Gbade-O/Senior-Design-GUI/Hardware/photos/IMG_20170424_153510.jpg

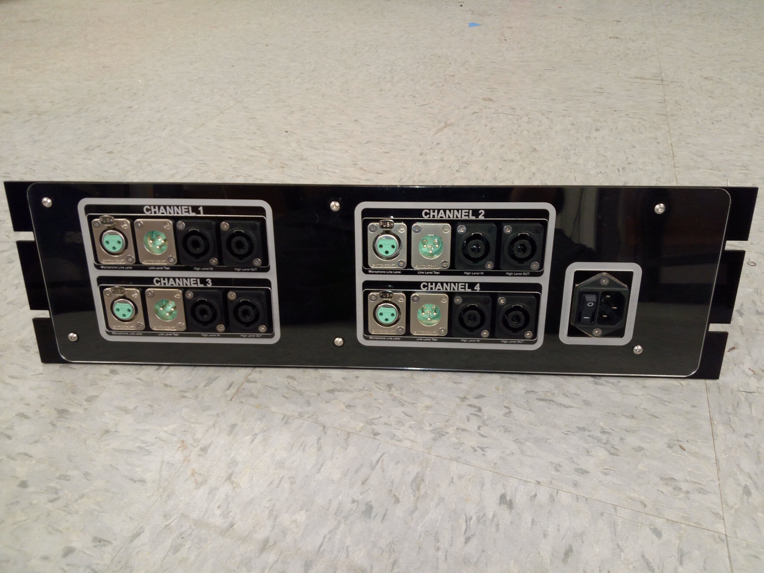
Hardware/photos/IMG_20170424_153510.jpg
