Gbade-O/Senior-Design-GUI/Hardware/Panel Overlays/3U_REAR_PANEL_OVERLAY.pdf

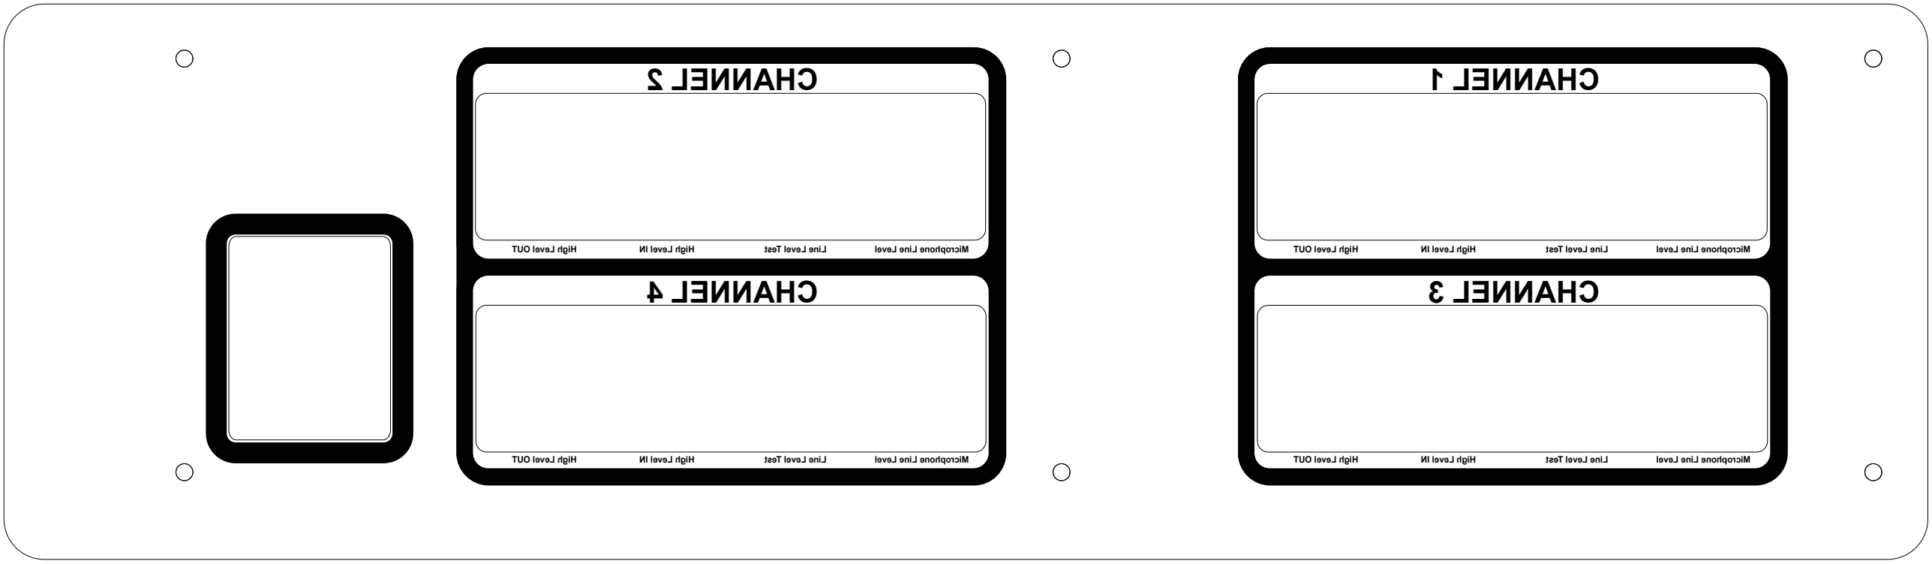
[picture p3: figure]
CHANNEL 2; CHANNEL 4; CHANNEL 1; CHANNEL 3

Microphone Line Level Line Level Test High Level IN High Level OUT

Microphone Line Level Line Level Test High Level IN High Level OUT

Microphone Line Level Line Level Test High Level IN High Level OUT

Microphone Line Level Line Level Test High Level IN High Level OUT
