Gbade-O/Senior-Design-GUI/Hardware/DPDT_Dimensions.PNG

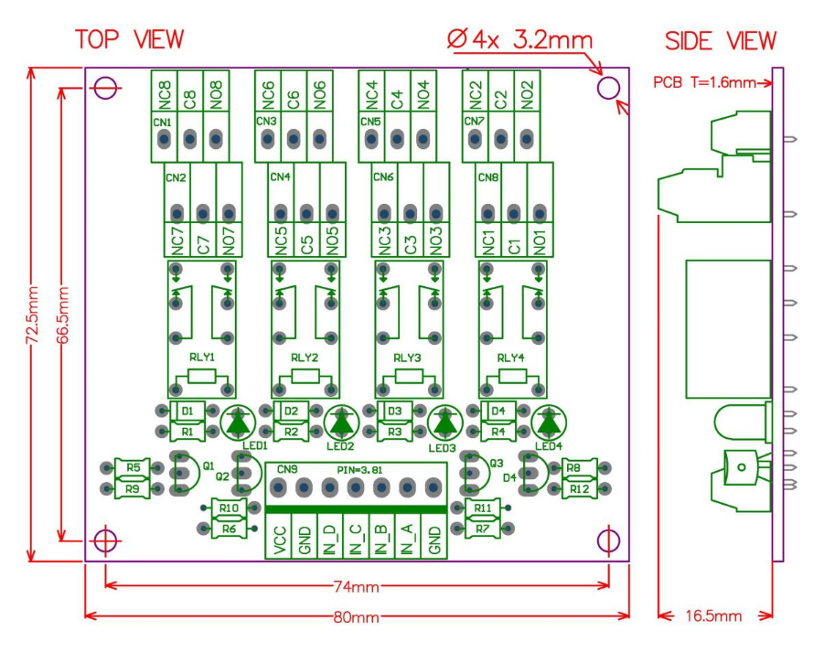
Hardware/DPDT_Dimensions.PNG
