Gbade-O/Senior-Design-GUI/Hardware/HardwareSystemRevB.PNG

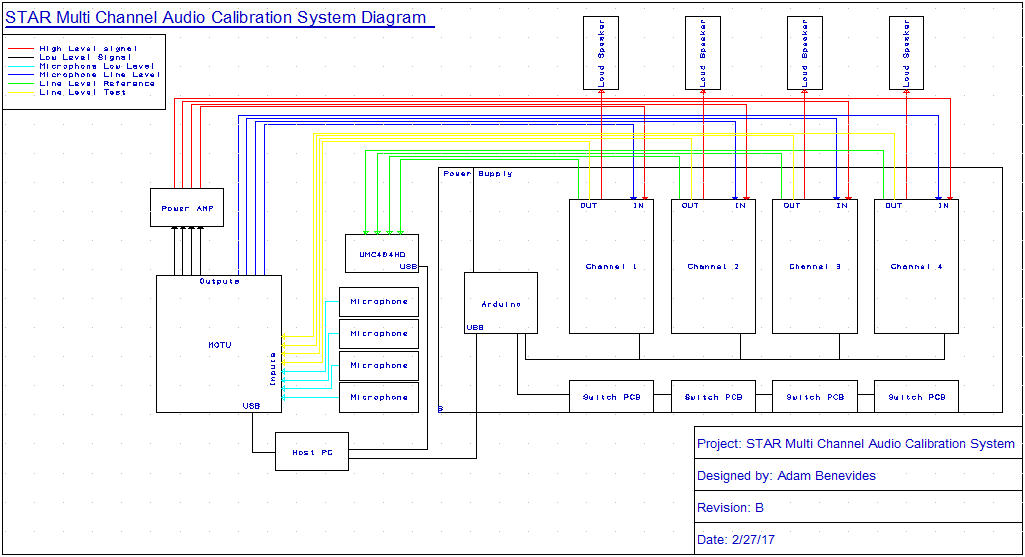
Hardware/HardwareSystemRevB.PNG
