Gbade-O/Senior-Design-GUI/Hardware/Mega_Dimensions.PNG

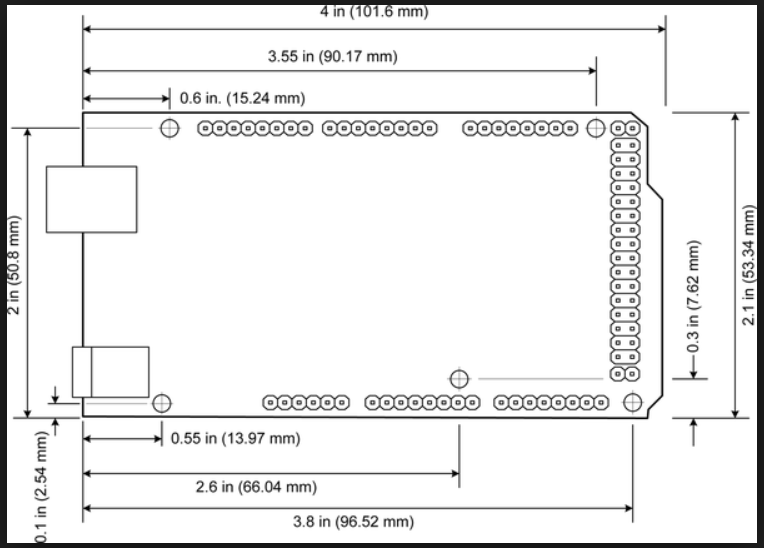
Hardware/Mega_Dimensions.PNG
