Gbade-O/Senior-Design-GUI/Hardware/Panels/Capture.PNG

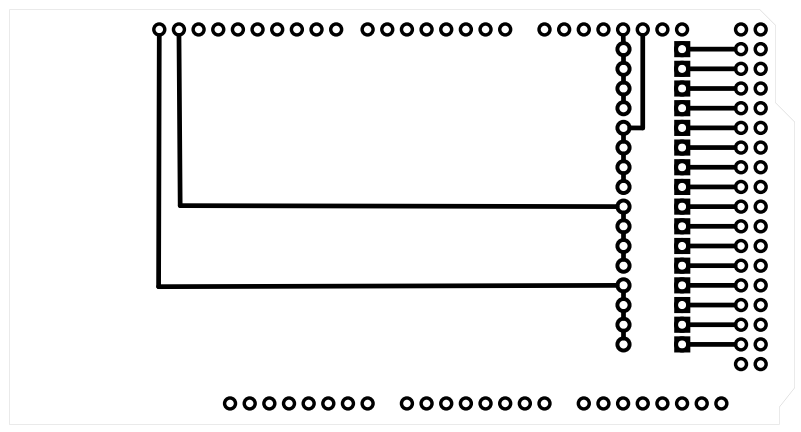
Hardware/Panels/Capture.PNG
