Gbade-O/Senior-Design-GUI/Hardware/Panels/FRONT_PANEL.PNG

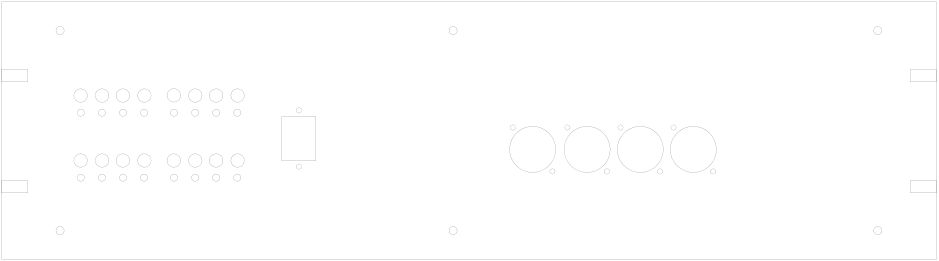
Hardware/Panels/FRONT_PANEL.PNG
