Gbade-O/Senior-Design-GUI/Hardware/Panels/FRONT_PANEL_BRACE.PNG

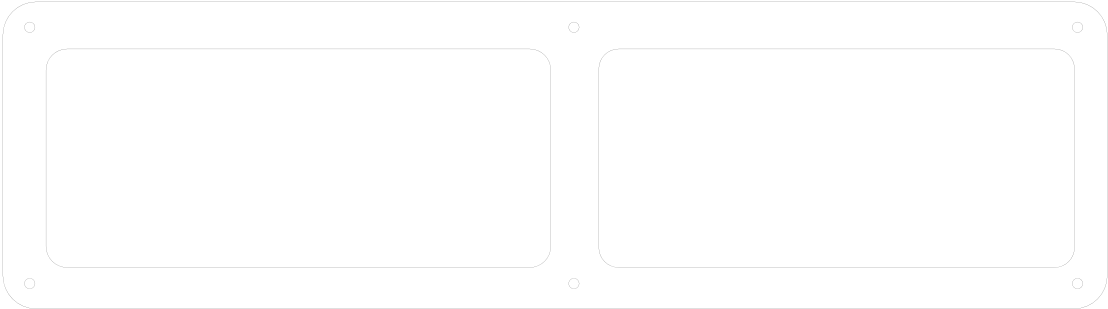
Hardware/Panels/FRONT_PANEL_BRACE.PNG
