Gbade-O/Senior-Design-GUI/Hardware/Panels/FRONT_PANEL_OVERLAY.PNG

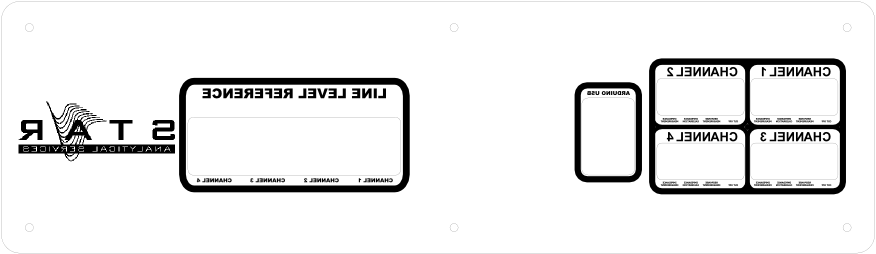
Hardware/Panels/FRONT_PANEL_OVERLAY.PNG
