Gbade-O/Senior-Design-GUI/Hardware/Panels/INTERNAL_PANEL.PNG

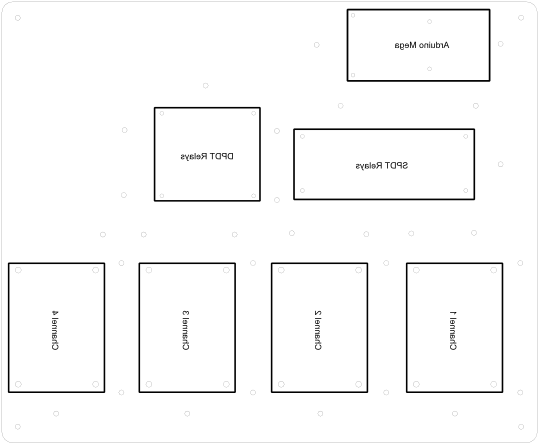
Hardware/Panels/INTERNAL_PANEL.PNG
