Gbade-O/Senior-Design-GUI/Hardware/Panels/REAR_PANEL.PNG

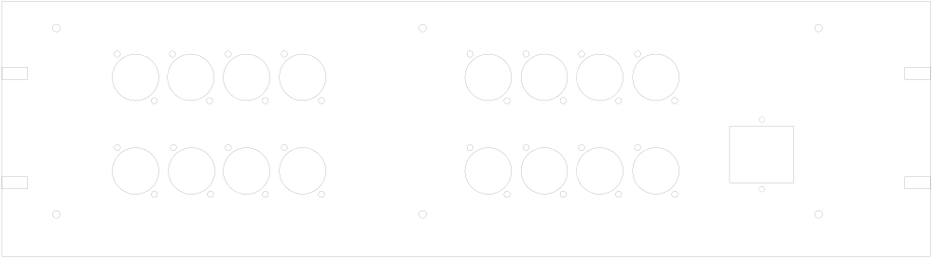
Hardware/Panels/REAR_PANEL.PNG
