Gbade-O/Senior-Design-GUI/Hardware/Panels/REAR_PANEL_BRACE.PNG

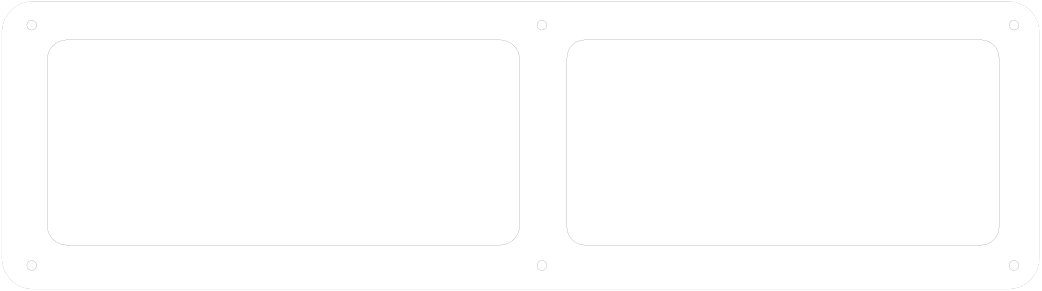
Hardware/Panels/REAR_PANEL_BRACE.PNG
