Gbade-O/Senior-Design-GUI/Hardware/Panels/REAR_PANEL_OVERLAY.PNG

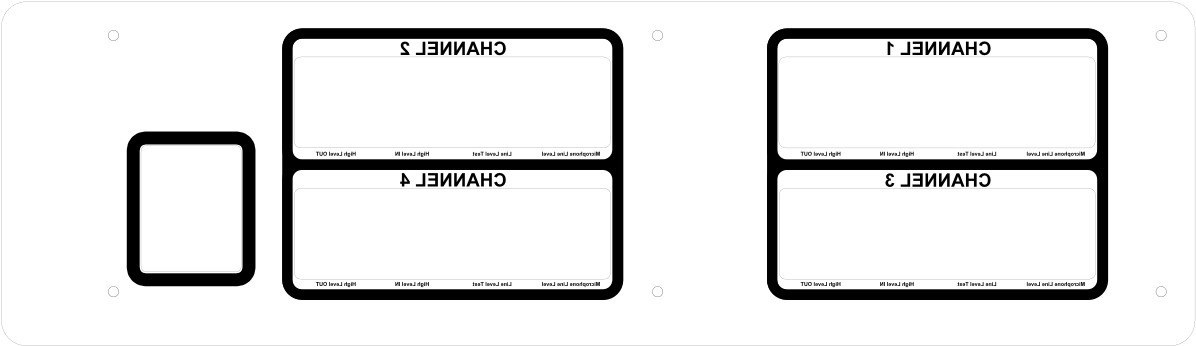
Hardware/Panels/REAR_PANEL_OVERLAY.PNG
