Gbade-O/Senior-Design-GUI/Hardware/photos/IMG_20170407_110844.jpg

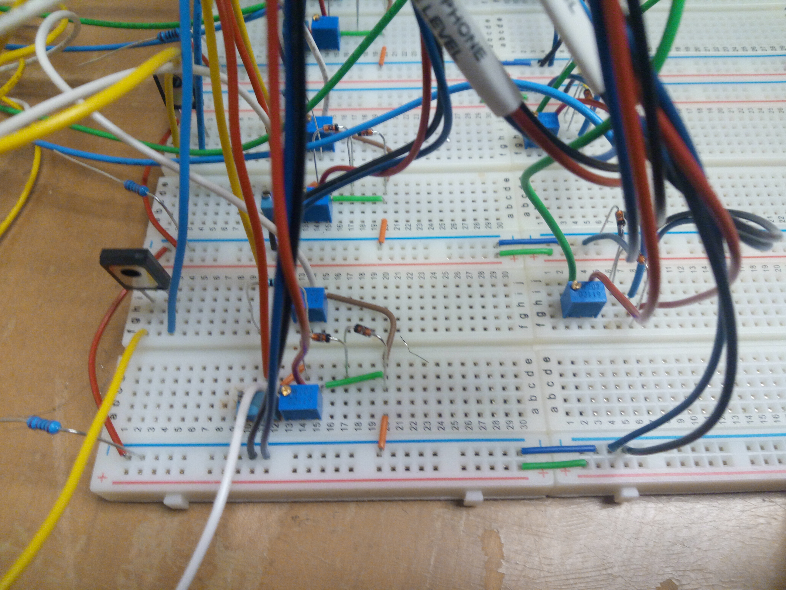
Hardware/photos/IMG_20170407_110844.jpg
