Gbade-O/Senior-Design-GUI/Hardware/photos/IMG_20170407_110850.jpg

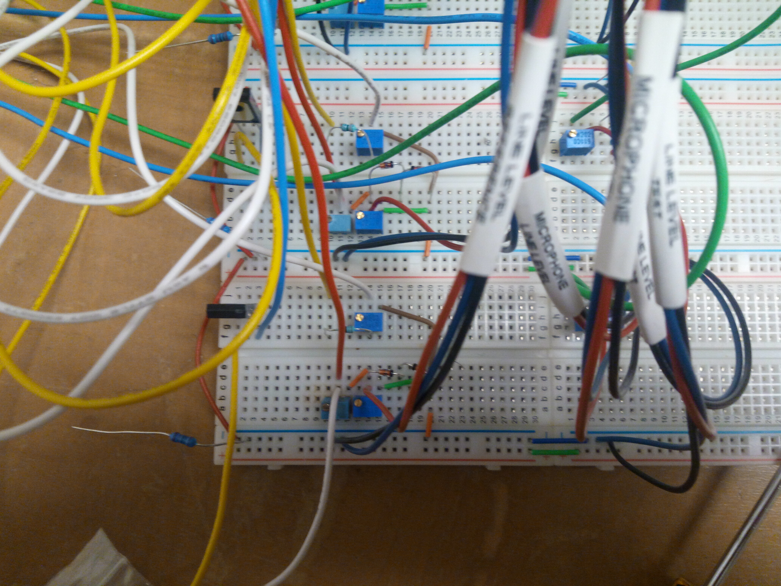
Hardware/photos/IMG_20170407_110850.jpg
