Gbade-O/Senior-Design-GUI/Hardware/photos/IMG_20170414_150326.jpg

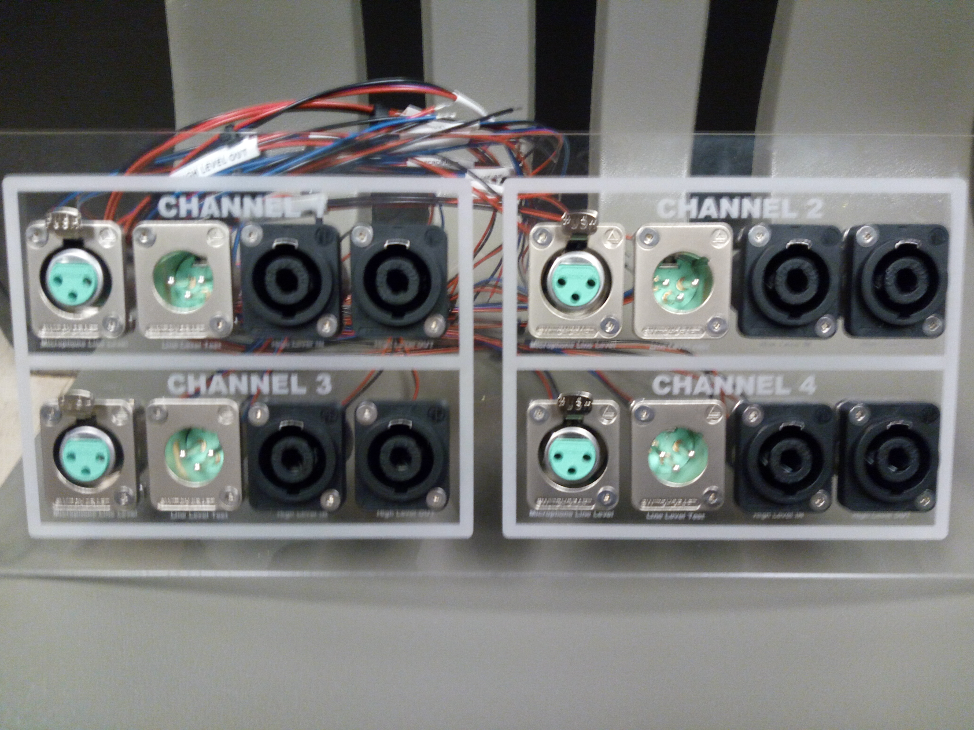
Hardware/photos/IMG_20170414_150326.jpg
