Gbade-O/Senior-Design-GUI/Hardware/photos/IMG_20170421_161729.jpg

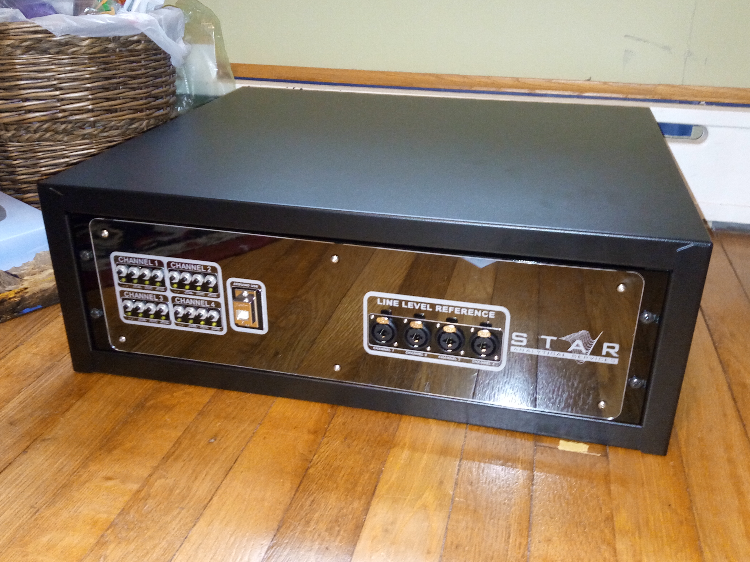
Hardware/photos/IMG_20170421_161729.jpg
