Gbade-O/Senior-Design-GUI/Hardware/photos/IMG_20170422_165607.jpg

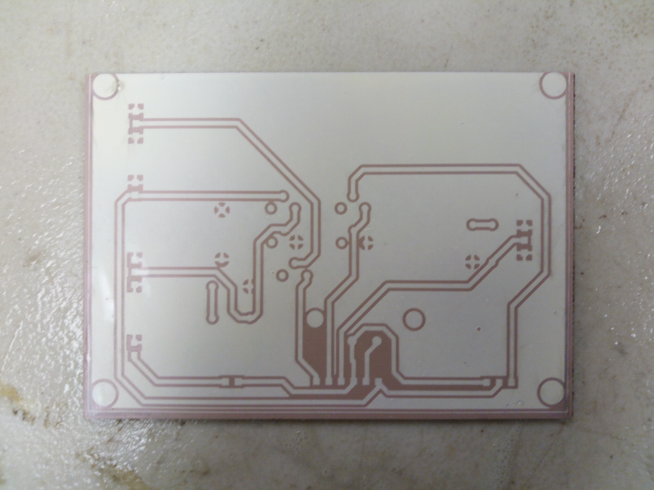
Hardware/photos/IMG_20170422_165607.jpg
