Gbade-O/Senior-Design-GUI/Hardware/photos/IMG_20170422_202816.jpg

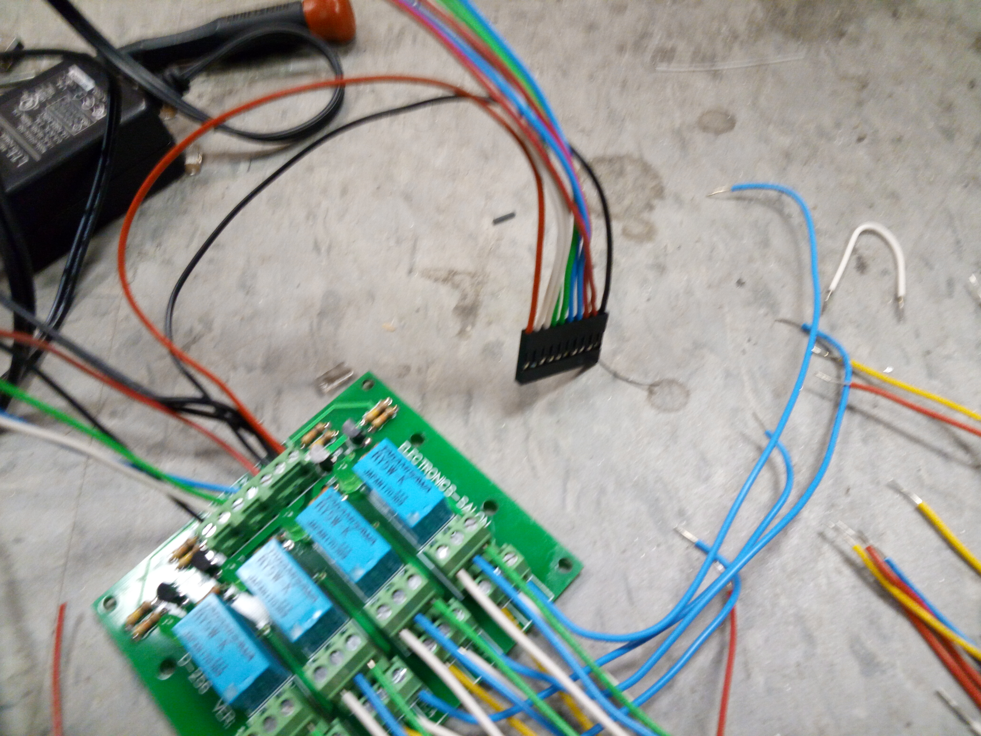
Hardware/photos/IMG_20170422_202816.jpg
