Gbade-O/Senior-Design-GUI/Hardware/photos/IMG_20170424_152419.jpg

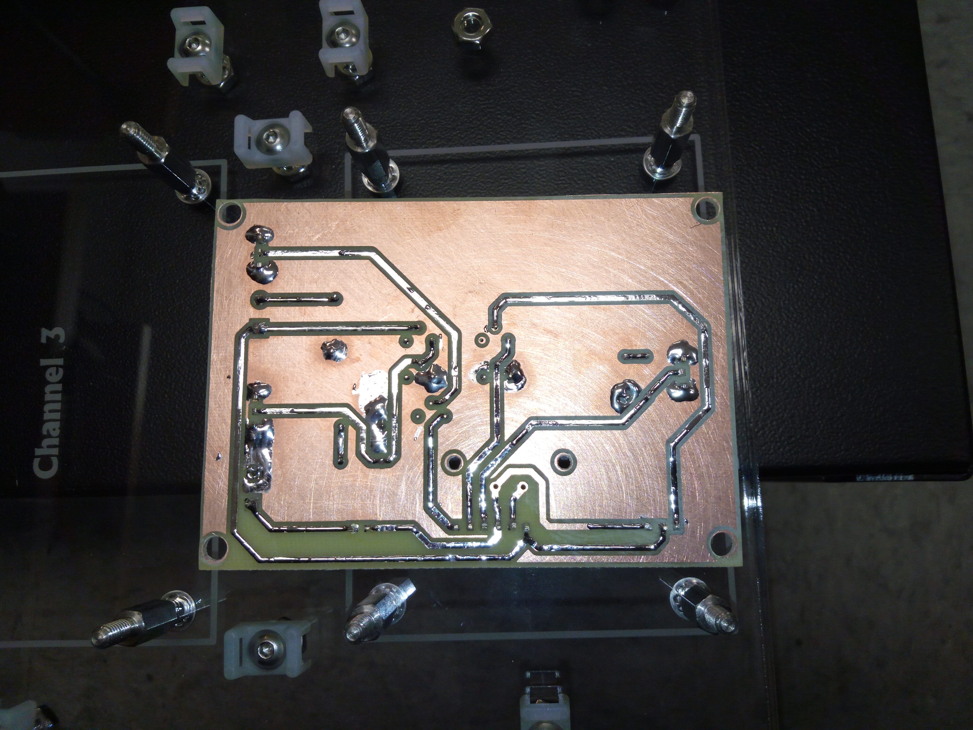
Hardware/photos/IMG_20170424_152419.jpg
