Gbade-O/Senior-Design-GUI/Hardware/photos/IMG_20170424_153402.jpg

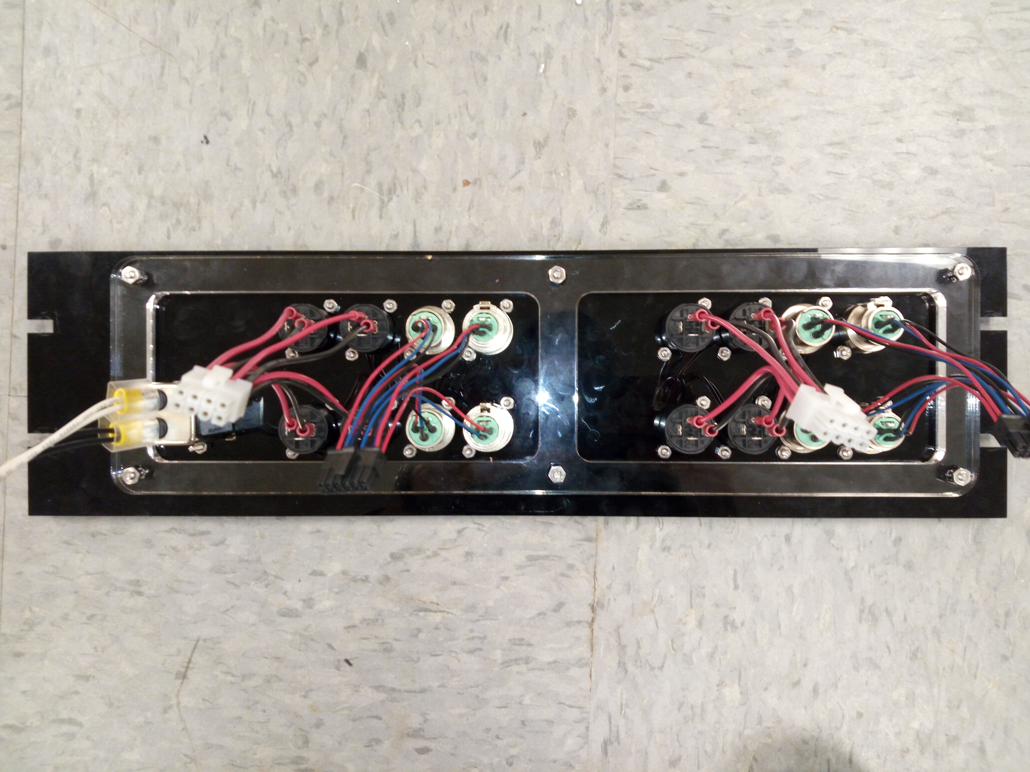
Hardware/photos/IMG_20170424_153402.jpg
