Gbade-O/Senior-Design-GUI/Hardware/photos/IMG_20170424_153427.jpg

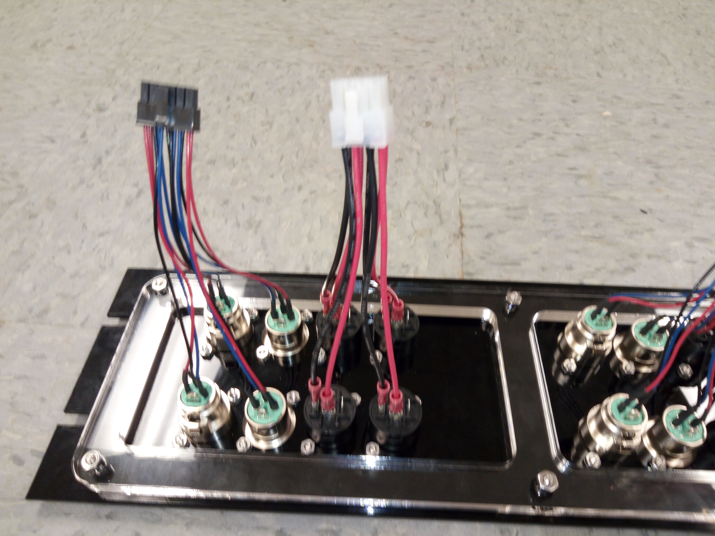
Hardware/photos/IMG_20170424_153427.jpg
