Gbade-O/Senior-Design-GUI/Hardware/photos/IMG_20170424_153449.jpg

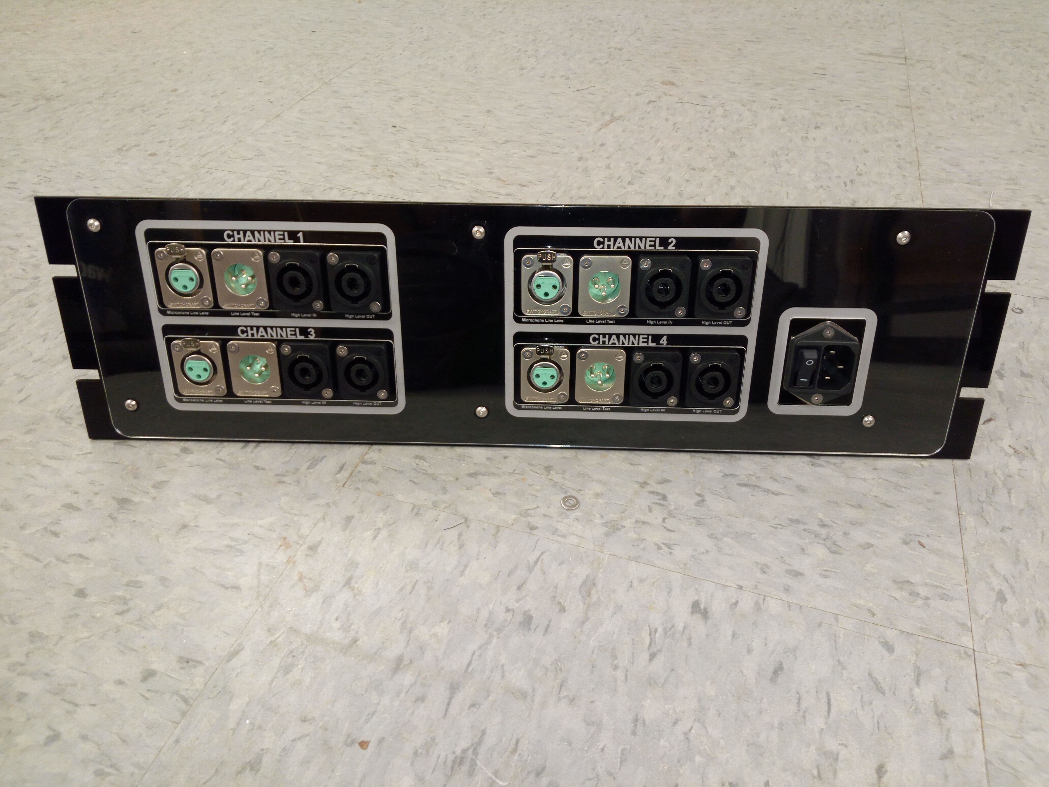
Hardware/photos/IMG_20170424_153449.jpg
