Gbade-O/Senior-Design-GUI/Hardware/photos/IMG_20170426_191719.jpg

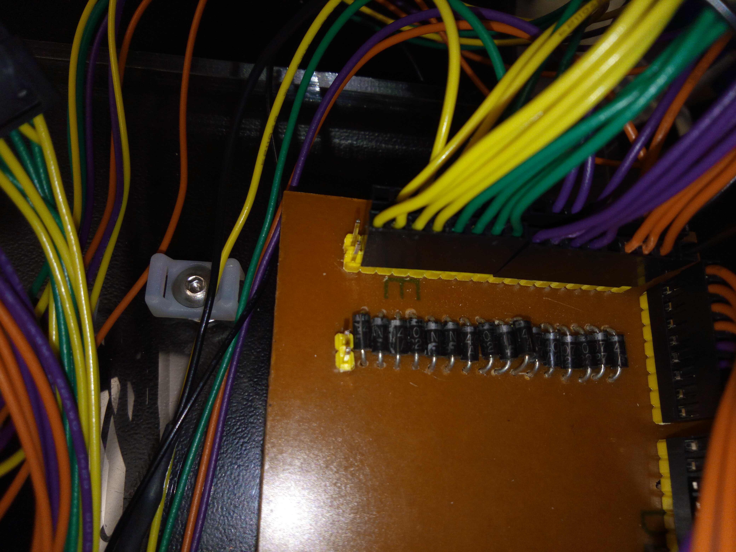
Hardware/photos/IMG_20170426_191719.jpg
