Gbade-O/Senior-Design-GUI/Hardware/photos/IMG_20170426_210206.jpg

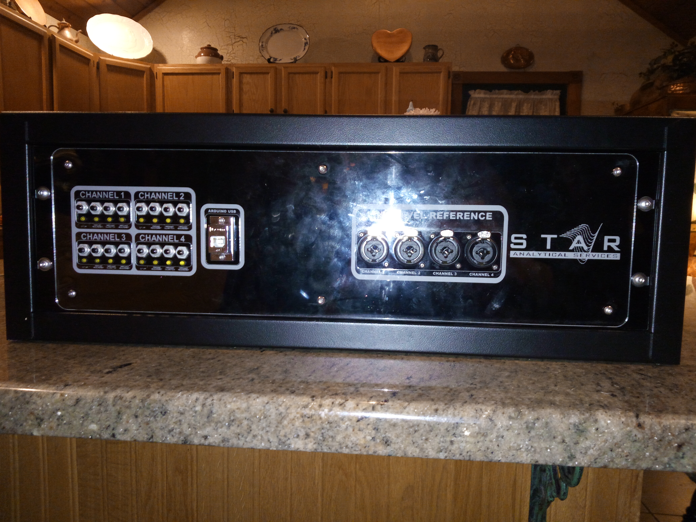
Hardware/photos/IMG_20170426_210206.jpg
