Gbade-O/Senior-Design-GUI/Hardware/photos/IMG_20170426_210301.jpg

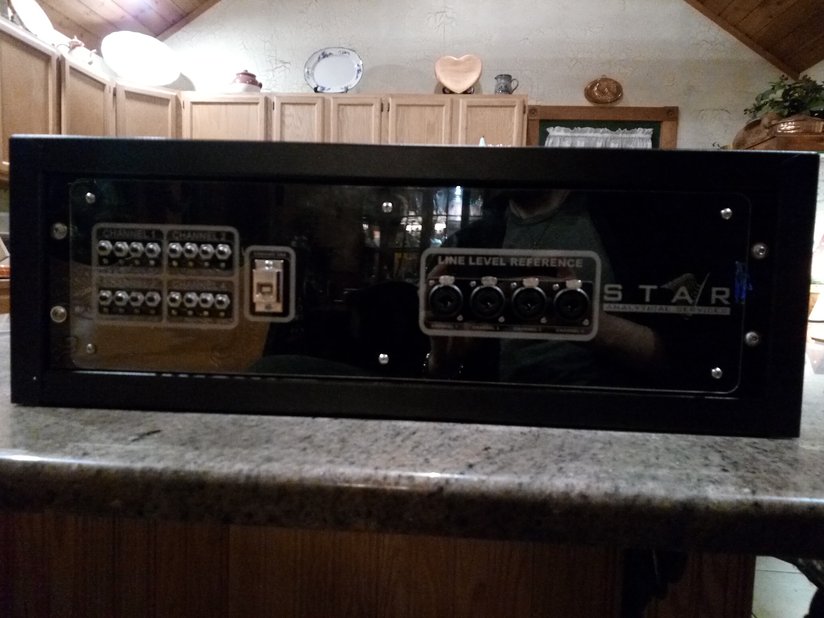
Hardware/photos/IMG_20170426_210301.jpg
