Gbade-O/Senior-Design-GUI/Hardware/photos/IMG_20170426_212249.jpg

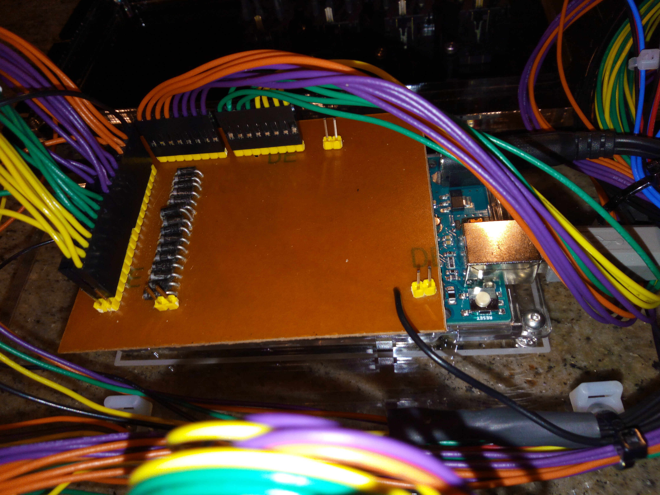
Hardware/photos/IMG_20170426_212249.jpg
