Gbade-O/Senior-Design-GUI/Hardware/MeasurementBox_Rev_C_BOM.xlsx

 | STAR Multi Channel Audio Calibration System
 | Four Track Measuring Box Rev:C
 | 2017-04-30
ITEM # | DESCRIPTION | MFG. | MFG. P/N | VENDOR | VENDOR P/N | QTY REQ. | UNIT COST | SYSTEM COST | REFERENCE DESIGNATOR
1 | TRIMMER, 10K OHM 1/4W | BOURNES | PV37W103C01B00 | DIGIKEY | 490-2970-ND | 3 | $2.29 | $6.87 | N/A
2 | TRIMMER, 2K OHM 1/4W | BOURNES | 3266W-1-202LF | DIGIKEY | 3266W-202LF-ND | 4 | $4.16 | $16.64 | N/A
3 | RESISTOR, 8.2K OHM 1/4W 1% AXIAL | STACKPOLE ELECTRONICS | RNMF14FTC8K20 | DIGI-KEY | S8.2KCACT-ND | 10 | $0.10 | $1.00 | R1,R3
4 | RESISTOR, 1K OHM 1/4W 1% AXIAL | YAGEO | MFR-25FBF52-1K | DIGI-KEY | 1.00KXBK-ND | 10 | $0.10 | $1.00 | R6
5 | RESISTOR, 910 OHM 1/4W 1% AXIAL | STACKPOLE ELECTRONICS | RNMF14FTC910R | DIGI-KEY | S910CACT-ND | 10 | $0.10 | $1.00 | R2,R4
6 | RESISTOR, 220 OHM 1/4W 1% AXIAL | STACKPOLE ELECTRONICS | RNMF14FTC220R | DIGI-KEY | S220CACT-ND | 20 | $0.07 | $1.44 | N/A
7 | RESISTOR, 715 OHM 1/4W 1% AXIAL | YAGEO | MFR-25FBF52-715R | DIGI-KEY | 715XBK-ND | 10 | $0.10 | $1.00 | R5
8 | RESISTOR, 27 OHM 10W 1% TO126 | OHMITE | TNP10SC27R0FE | DIGIKEY | TNP10SC27R0FE-ND | 5 | $3.08 | $15.40 | R9
9 | HEATSINK, TO-126 1 CLIP | OHMITE | C126-025-1VE | MOUSER | 588-C126-025-1VE | 5 | $3.18 | $15.90 | N/A
10 | CONNECTOR, XLR FEMALE, 1/4", HYBRID | NEUTRIK | NCJ6FI-S | MOUSER | 568-NCJ6FI-S | 5 | $3.35 | $16.75 | LINE LEVEL REF
11 | CONNECTOR, XLR FEMALE 3P | SWITCHCRAFT | DE3F | MOUSER | 502-DE3F | 5 | $2.56 | $12.80 | IN1,IN2,IN3,IN4
12 | CONNECTOR, SpeakON FEMALE 4P | NEUTRIK | NL4MP | MOUSER | 568-NL4MP | 9 | $2.67 | $24.03 | PA1,PA2,PA3,PA4 LS1,LS2,LS3,LS4
13 | CONNECTOR, USB Adapter B-A, Shielded | L-COM | ECF504-BAS | NEWARK | 22J8057 | 1 | $9.35 | $9.35 | ARDUINO USB
14 | CONNECTOR, XLR MALE 3P | SWITCHCRAFT | DE3M | MOUSER | 502-DE3M | 5 | $3.75 | $18.75 | OUT1,OUT2,OUT3,OUT4,OUT5,OUT6,OUT7,OUT8
15 | DIODE, 1N4001 | MICRO COMMERCIAL CO | 1N4001-TP | DIGIKEY | 1N4001-TPMSTR-ND | 16 | $0.10 | $1.66 | D5,D6,D7,D8,D9,D10,D11,D12,D13,D14,D15,D16,D17,D18,D19,D20
16 | DIODE, ZENER 4.1V AXIAL | NXP | BZX79-C3V9,113 | MOUSER | 771-BZX79-C3V9113 | 20 | $0.13 | $2.60 | D1,D2,D3,D4
17 | RELAY BOARD, SPDT | ELEGOO | 8-CHNL RELAY | AMAZON | N/A | 1 | $9.99 | $9.99 | N/A
18 | RELAY BOARD, DPDT | ELECTRONICS-SALON | MD-D256/12V-1 | AMAZON | N/A | 1 | $21.99 | $21.99 | N/A
19 | PUSH BUTTON | GRAYHILL | 30-3 | MOUSER | 706-30-3 | 17 | $2.70 | $45.90 | MODE1,MODE2,MODE3,MODE4
20 | ATMEGA328P ARDUINO MEGA | ARDUINO | A000067 | DIGIKEY | 1050-1018-ND | 1 | $26.13 | $26.13 | N/A
21 | A/D CONVERTER | BEHRINGER | UMC404HD | BHPHOTOVIDEO | BEUMC404HD | 1 | $99.99 | $99.99 | N/A
22 | CABLE, XLR M to XLR F | PEARSTONE | SM-15 | BHPHOTOVIDEO | PESM15 | 8 | $7.49 | $59.92 | N/A
23 | CABLE, 1/4" M to 1/4" M PHONO | HOSA | CPP-801 | SWEETWATER | CPP-801 | 5 | $21.99 | $109.95 | N/A
24 | CABLE, SpeakON | GLS AUDIO | 37-430 | AMAZON | 37-430 | 6 | $39.99 | $239.94 | N/A
25 | HOOKUP WIRE, VARIOUS COLORS 22AWG | AWC | UL-1007 | AWC | UL-1007 | 1 | by length | by length | N/A
26 | HOOKUP WIRE, VARIOUS COLORS 16AWG | AWC | UL-1007 | AWC | UL-1007 | 1 | by length | by length | N/A
27 | HOOKUP WIRE, VARIOUS COLORS 24AWG | AWC | UL-1007 | AWC | UL-1007 | 1 | by length | by length | N/A
 |  |  |  |  |  |  | TOTAL | $760.00
NOTE: All parts listed on this BOM depict ONLY the electronics required to make a FTMB. All hardware is arbitrarily selected by the assembler.
All designed components (PCBs, panels, etc.) were manufactured in-house and by hand.
The original FTMB was created with the help of an Epilog HELIX Laser System, graciously lent out by Electromechanica Inc.
