Gbade-O/Senior-Design-GUI/Hardware/PCB/MeasurementBox_Rev_A_BOM.xlsx

 | STAR Multi Channel Audio Calibration System
 | Measuring Box Single Channel PCB Rev:A
 | 2016-12-07
ITEM # | DESCRIPTION | MFG. | MFG. P/N | VENDOR | VENDOR P/N | QTY REQ. | UNIT COST | SYSTEM COST | REFERENCE DESIGNATOR
1 | RESISTOR, 8.2K OHM 1/4W 1% AXIAL | STACKPOLE ELECTRONICS | RNMF14FTC8K20 | DIGI-KEY | S8.2KCACT-ND | 8 | $0.10 | $0.80 | R1,R3
2 | RESISTOR, 1K OHM 1/4W 1% AXIAL | YAGEO | MFR-25FBF52-1K | DIGI-KEY | 1.00KXBK-ND | 4 | $0.10 | $0.40 | R6
3 | RESISTOR, 910 OHM 1/4W 1% AXIAL | STACKPOLE ELECTRONICS | RNMF14FTC910R | DIGI-KEY | S910CACT-ND | 8 | $0.10 | $0.80 | R2,R4
4 | RESISTOR, 715 OHM 1/4W 1% AXIAL | YAGEO | MFR-25FBF52-715R | DIGI-KEY | 715XBK-ND | 4 | $0.10 | $0.40 | R5
5 | RESISTOR, 27 OHM 10W 1% TO126 | OHMITE | TNP10SC27R0FE | DIGIKEY | TNP10SC27R0FE-ND | 4 | $3.08 | $12.32 | R9
6 | CONNECTOR, XLR FEMALE 3P R/A | NEUTRIK | 3FD-V-I-0 | MOUSER | 568-3FD-V-I-0 | 16 | $2.56 | $40.96 | J3,J4,J5,J6
7 | CONNECTOR, XLR MALE 3P R/A | NEUTRIK | NC3MD-H-BAG | MOUSER | 568-NC3MDHBAG | 4 | $3.75 | $15.00 | J1
8 | DIODE, ZENER 4.1V AXIAL | NXP | BZX79-C3V9,113 | MOUSER | 771-BZX79-C3V9113 | 16 | $0.13 | $2.08 | D1,D2,D3,D4
9 | RELAY SPDT | OMRON | G5V-1-DC5 | DIGIKEY | Z773-ND | 4 | $1.99 | $7.96 | K2
10 | RELAY DPDT | OMRON | G5V-2-DC5 | DIGIKEY | Z767-ND | 4 | $2.88 | $11.52 | K1
11 | ATMEGA328P ARDUINO UNO | ARDUINO | A000099 | DIGIKEY | 1050-1124-ND | 1 | $26.13 | $26.13
12 | RACK PROJECT BOX 1U SILVER FACE | PENN ELCOM | R2100 | MCMELECTRONICS | 555-20825 | 1 | $59.99 | $59.99
13 | MEASURING BOX PCB |  |  |  |  | 4 | N/A | N/A
 |  |  |  |  |  |  | TOTAL | $178.36
