Gbade-O/Senior-Design-GUI/Hardware/Measurement_Box_Single_Channel_Rev-C_BOM.PNG

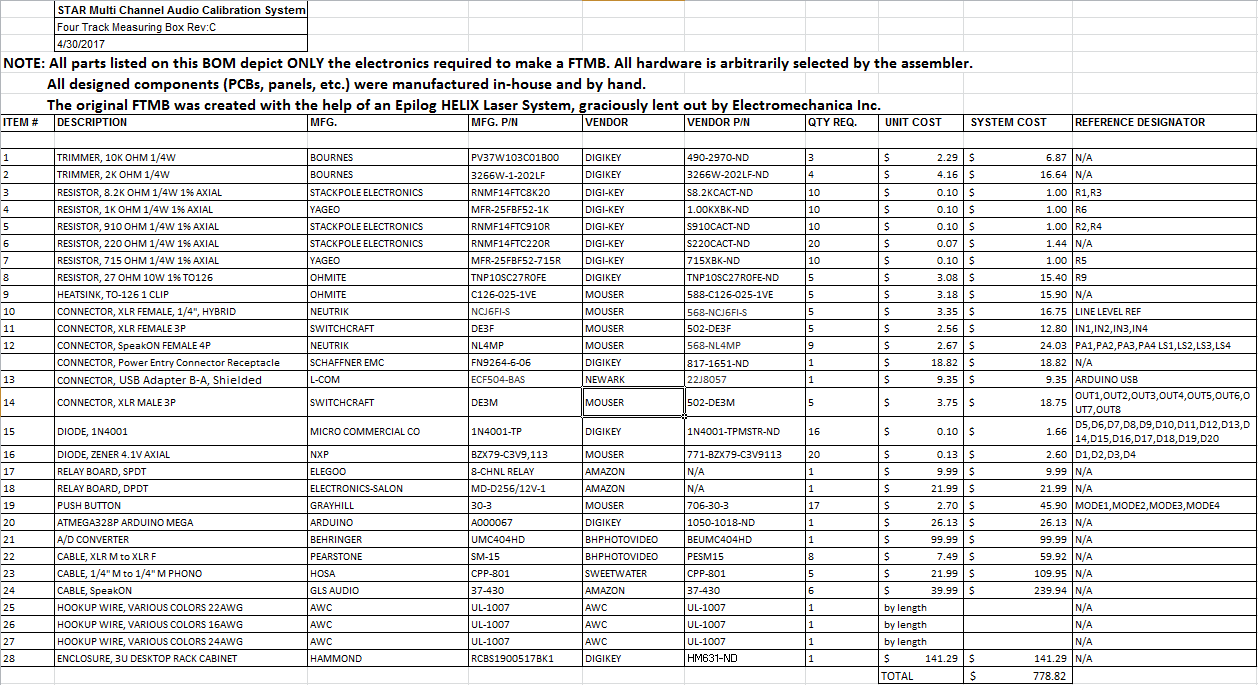
Hardware/Measurement_Box_Single_Channel_Rev-C_BOM.PNG
