Gbade-O/Senior-Design-GUI/Hardware/PCB/MeasurementBox_Channel1_Rev_C (PCB - Design Integrity Status Report).txt

Design Integrity Status Report
------------------------------

Report File    : C:\Users\Public\Documents\Easy-PC\Senior Design Project\MeasurementBox_Channel1_Rev_C (PCB - Design Integrity Status Report).txt
Report Written : Sunday, April 23, 2017
Design Path    : C:\Users\Public\Documents\Easy-PC\Senior Design Project\MeasurementBox_Channel1_Rev_C.pcb
Design Title   : 
Created        : 4/19/2017 4:24:52 PM
Last Saved     : 4/23/2017 11:36:15 AM
Editing Time   : 4298 min
Units          : thou (precision 0)

Checking integrity of Schematic "C:\Users\Public\Documents\Easy-PC\Senior Design Project\MeasurementBox_Channel1_Rev_C.sch" with PCB "C:\Users\Public\Documents\Easy-PC\Senior Design Project\MeasurementBox_Channel1_Rev_C.pcb"
================================================================================================================================================================================================================================

End Of Report.
