Gbade-O/Senior-Design-GUI/Hardware/PCB/MeasurementBox_Channel1_Rev_C - PCB.png

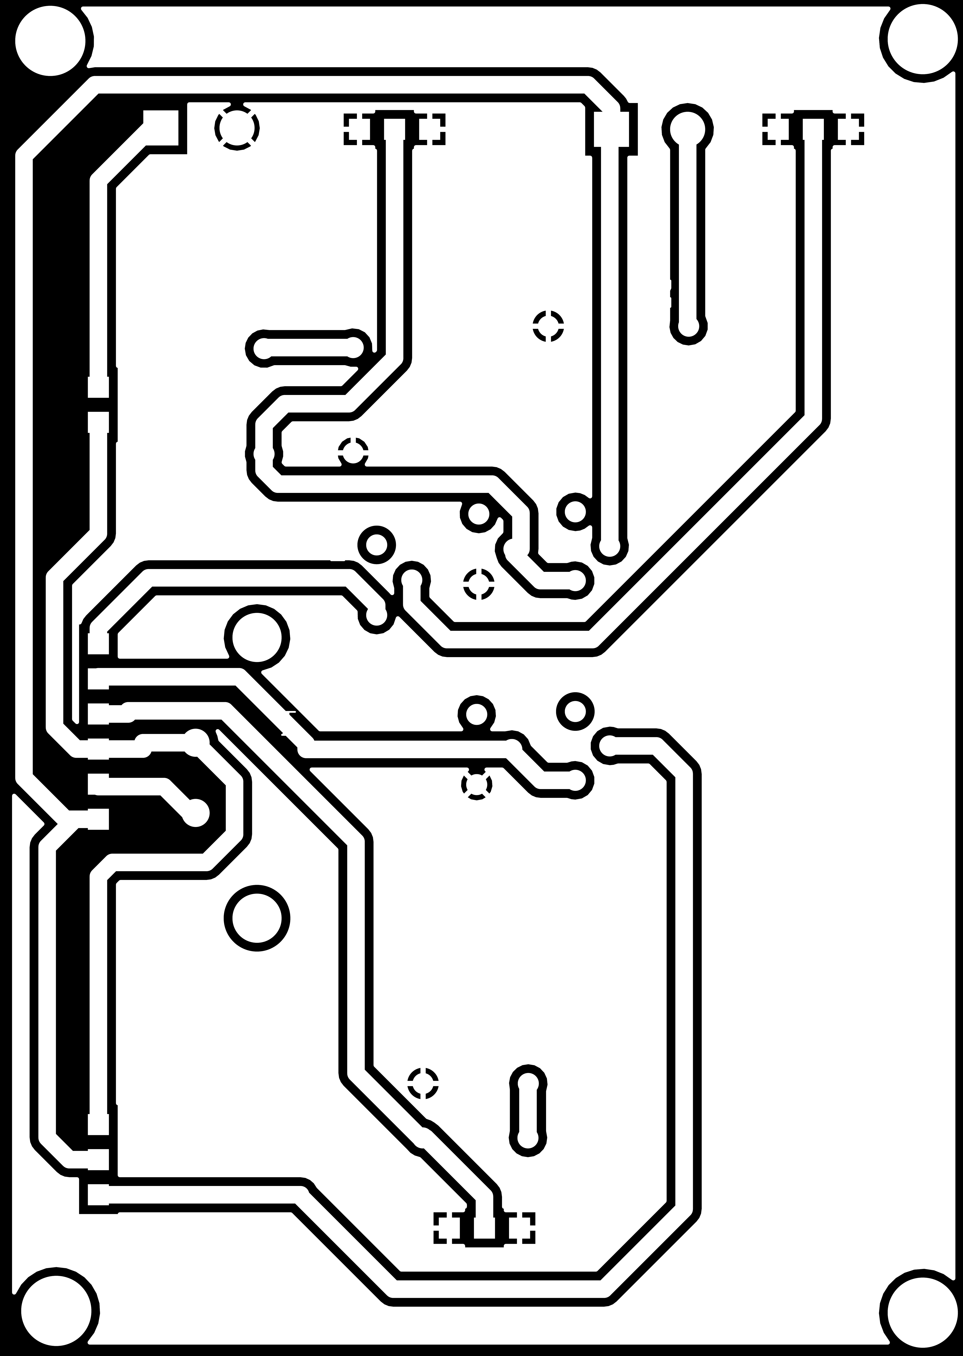
Hardware/PCB/MeasurementBox_Channel1_Rev_C - PCB.png
