Gbade-O/Senior-Design-GUI/Hardware/Panel Overlays/3U_FRONT_PANEL_OVERLAY.pdf

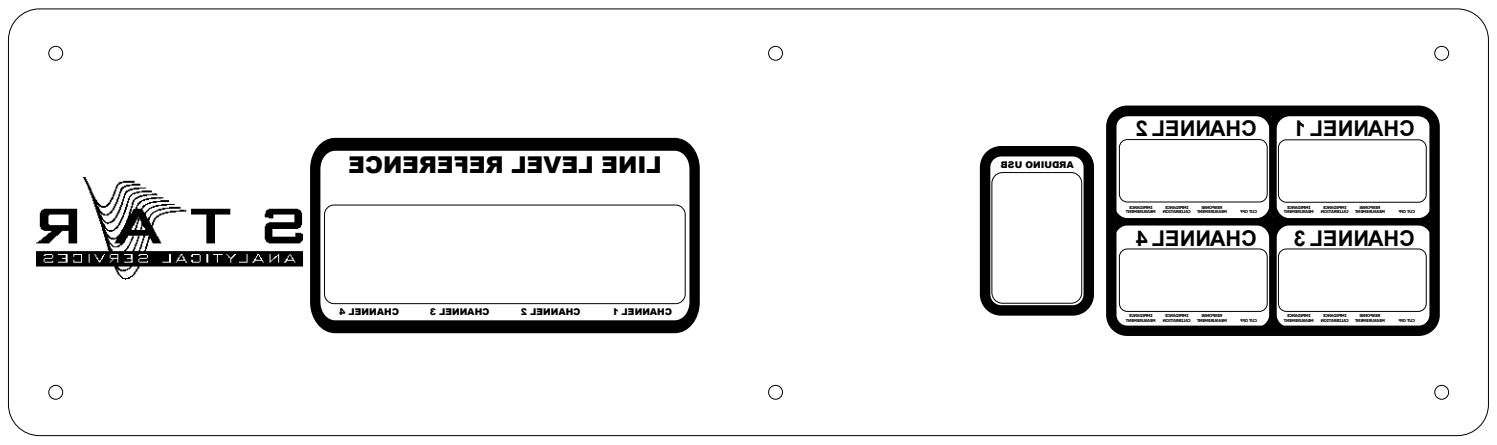
[picture p64: page 1]
CUT OFF; RESPONSE MEASUREMENT; IMPEDANCE CALIBRATION; IMPEDANCE MEASUREMENT; CHANNEL 1; ARDUINO USB; CHANNEL 2; CHANNEL 3; CHANNEL 4

LINE LEVEL REFERENCE

CHANNEL 4 CHANNEL 1 CHANNEL 2 CHANNEL 3
