Gbade-O/Senior-Design-GUI/Hardware/PCB/MeasurementBox_Channel1_Rev_C - PCB.pdf

J1

J4

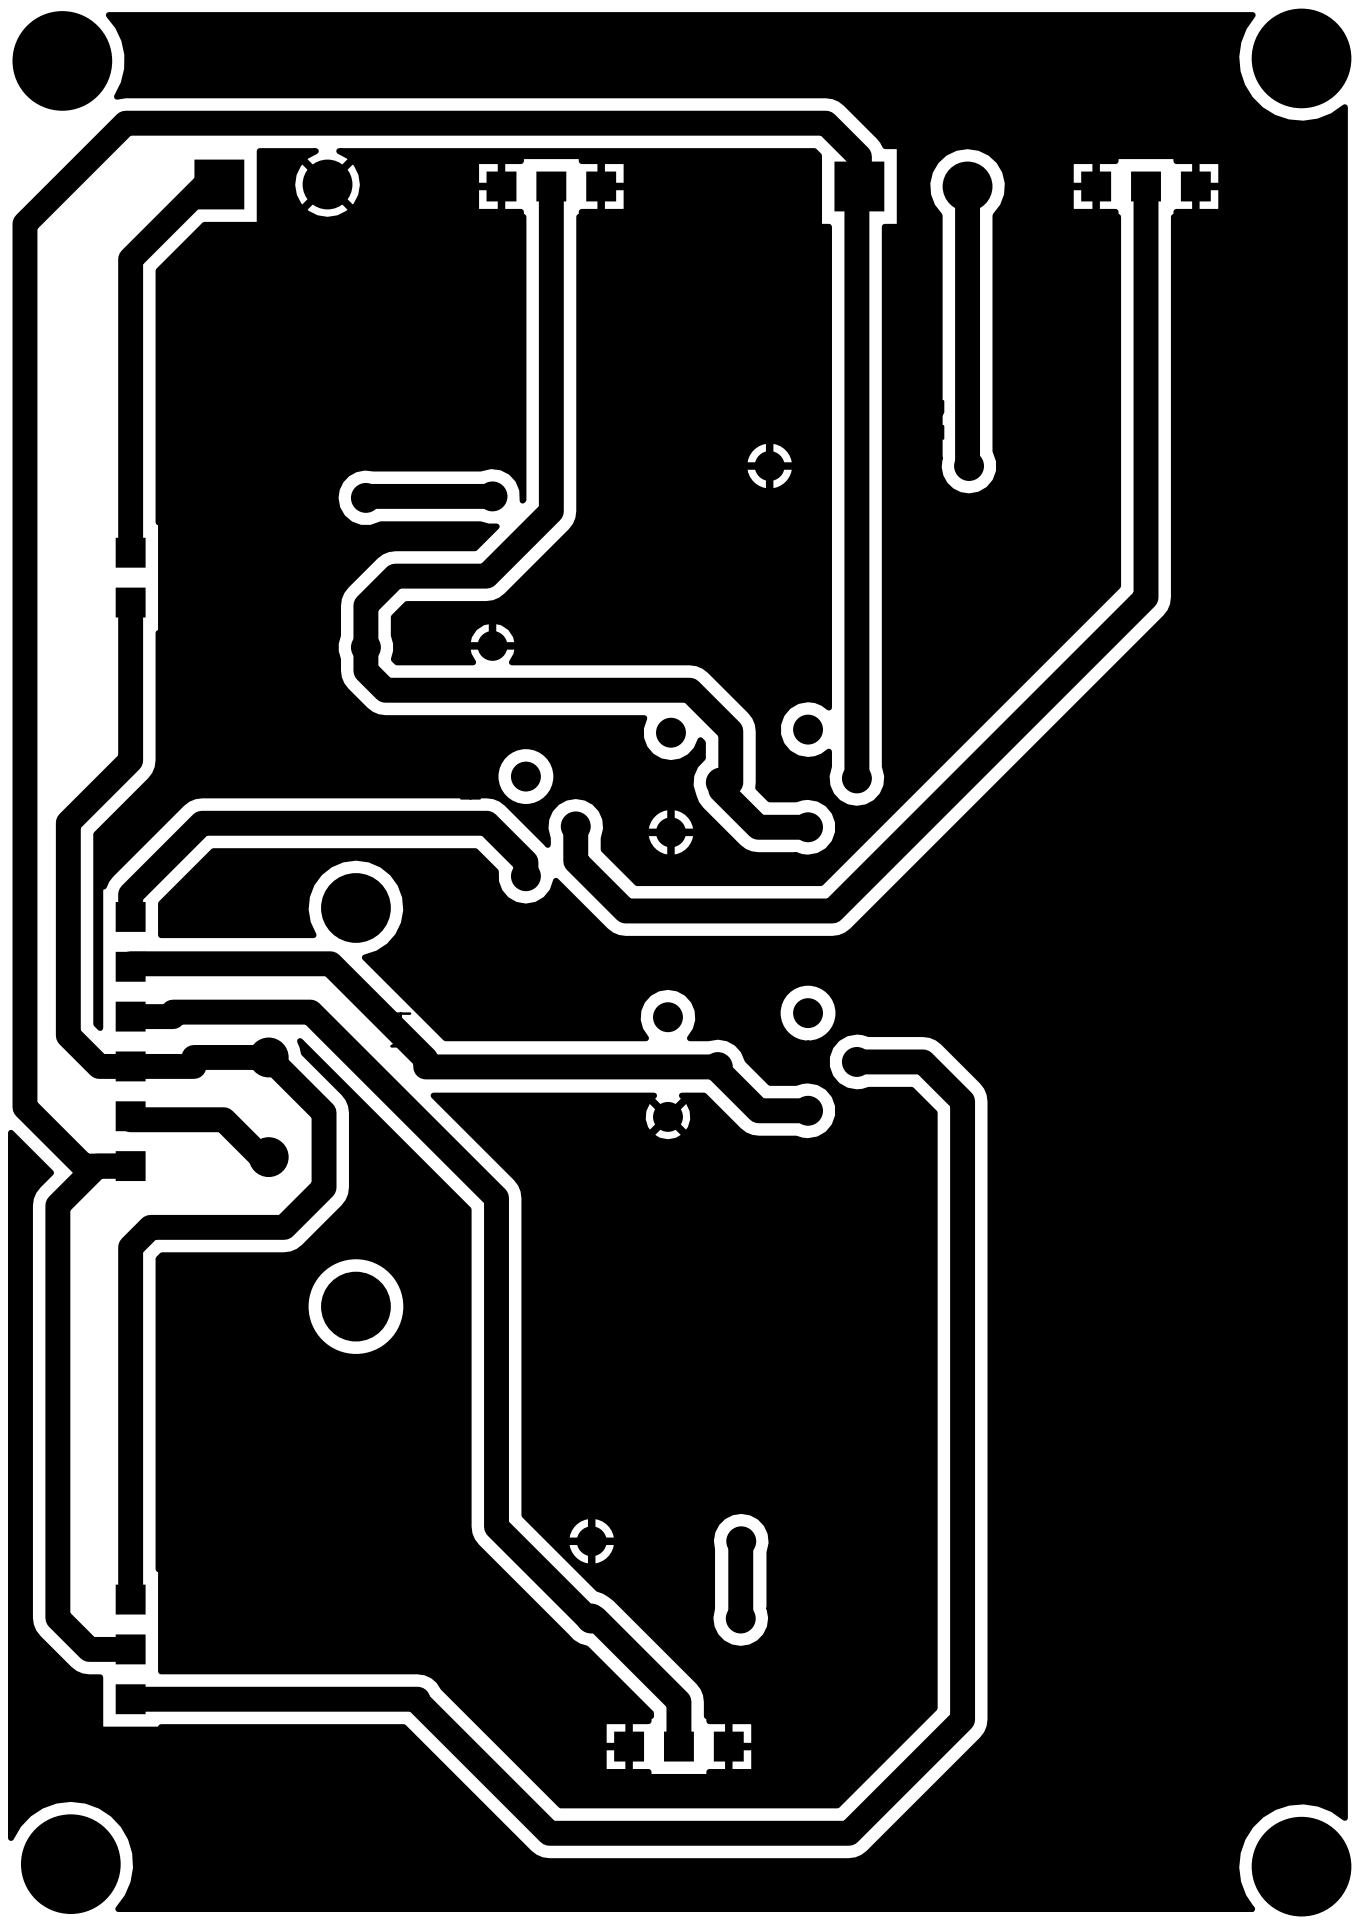
[picture p65: page 1]
