Gbade-O/Senior-Design-GUI/FTMB/Arduino_Sketch_final.pdf

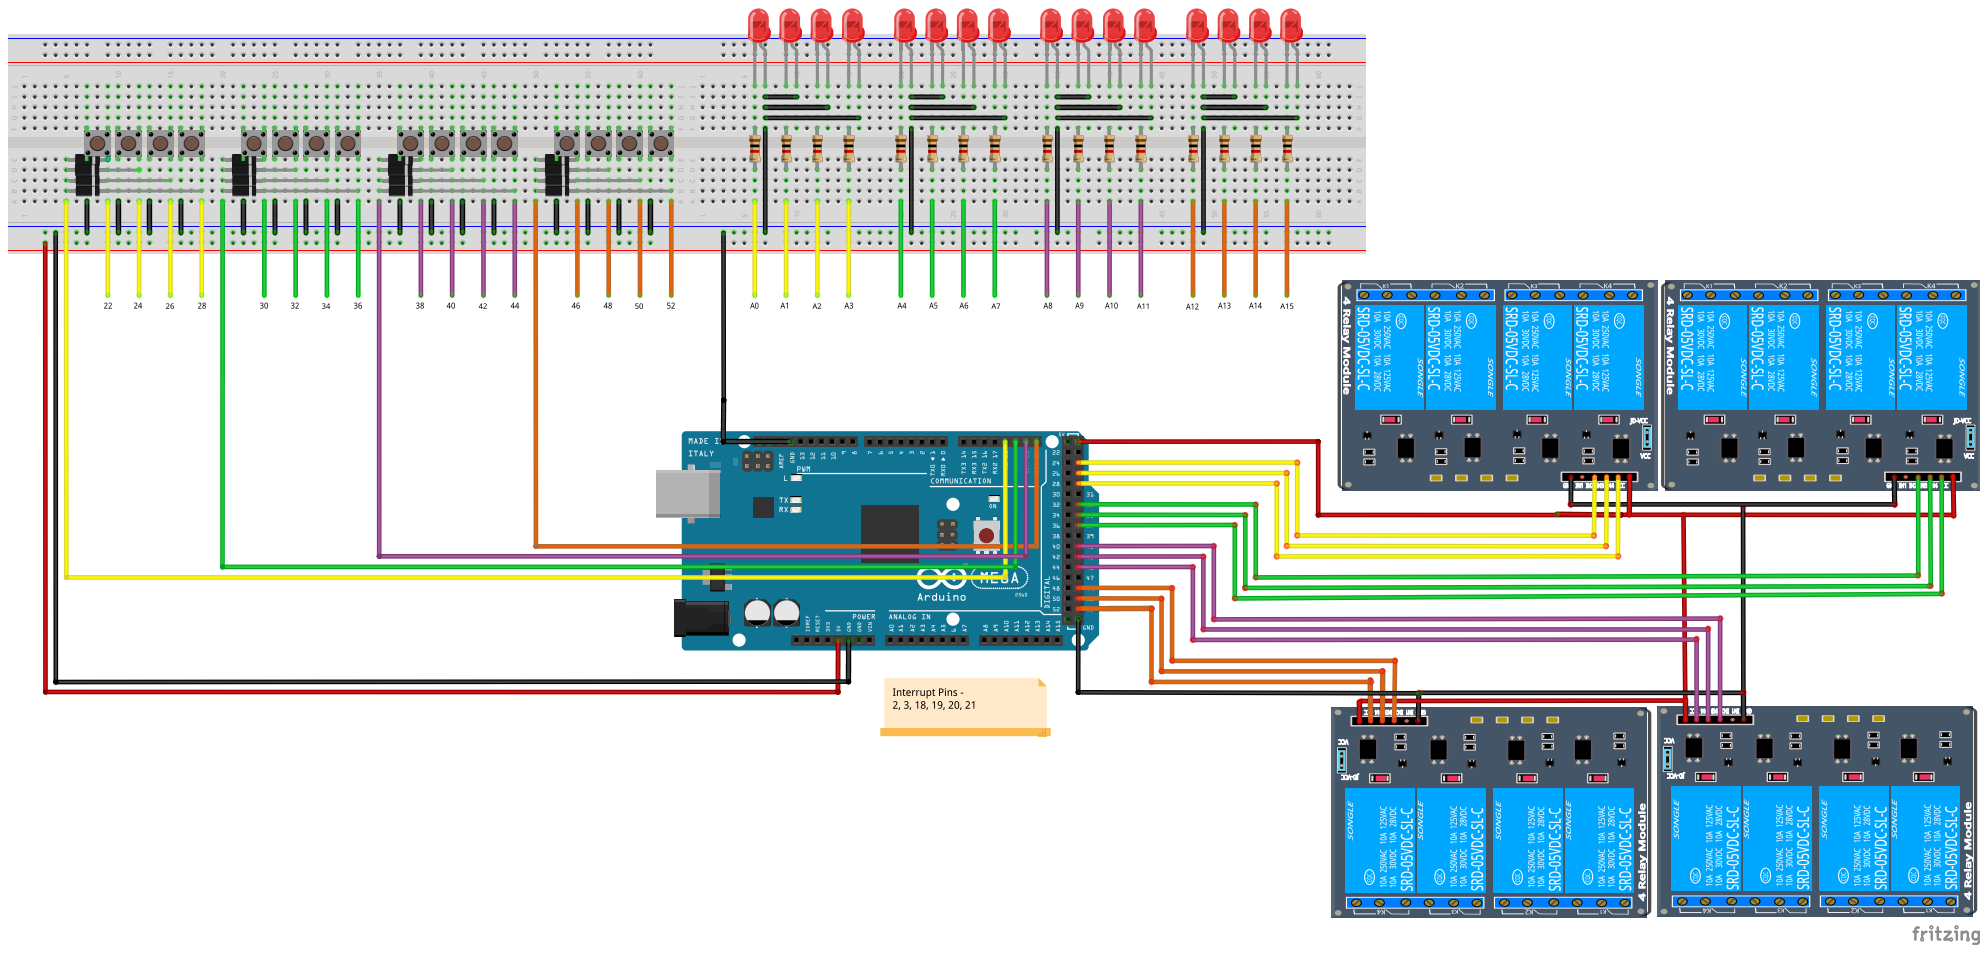
[picture p66: page 1]
