Gbade-O/Senior-Design-GUI/(list of files, drawings)

Other design files:
Hardware/PCB/MeasurementBox_Channel1_Rev_C.pcb
Hardware/PCB/~MeasurementBox_Channel1_Rev_C.pcb
